Ahmed-Amr-Farouk/-FPGA-CNN-Accelerator/Report/FSM States.png

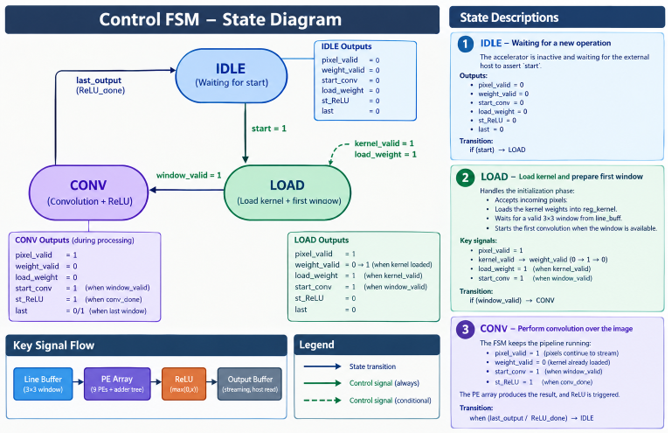
Report/FSM States.png
