Ahmed-Amr-Farouk/-FPGA-CNN-Accelerator/FPGA_Vivado/On-Chip Power Summary (Vivado, .saif Activity Applied).jpg

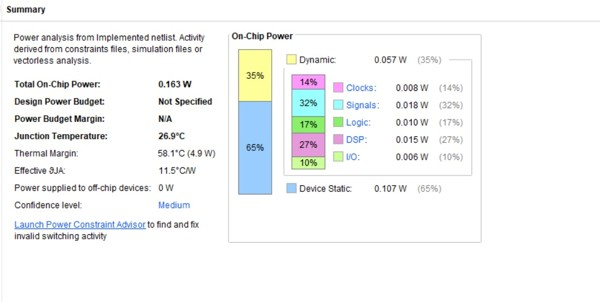
FPGA_Vivado/On-Chip Power Summary (Vivado, .saif Activity Applied).jpg
