Ahmed-Amr-Farouk/-FPGA-CNN-Accelerator/FPGA_Vivado/RTL Schematic Post-Synthesis.jpg

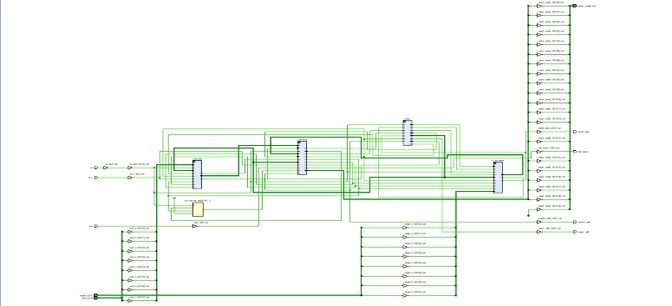
FPGA_Vivado/RTL Schematic Post-Synthesis.jpg
