Ahmed-Amr-Farouk/-FPGA-CNN-Accelerator/FPGA_Vivado/RTL Schematic.jpg

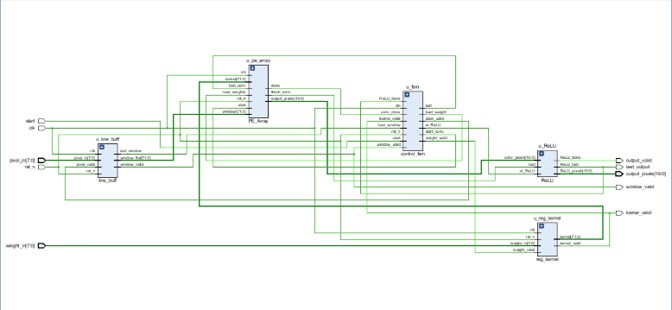
FPGA_Vivado/RTL Schematic.jpg
