Ahmed-Amr-Farouk/-FPGA-CNN-Accelerator/Report/System-Level Block Diagram.png

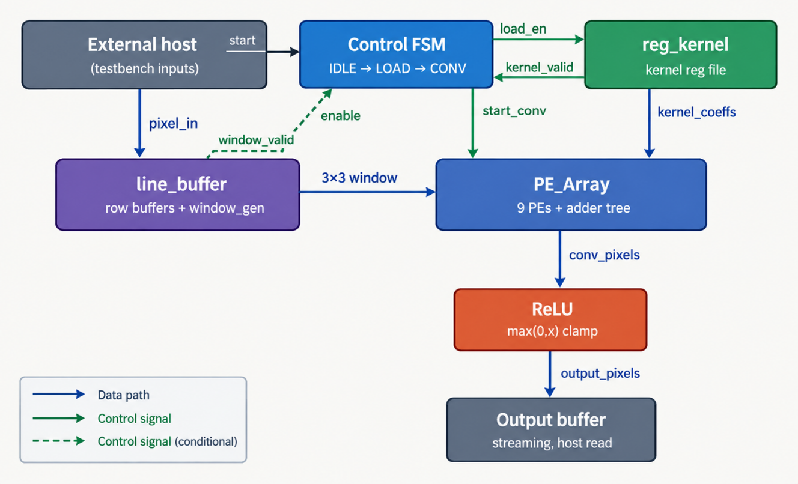
Report/System-Level Block Diagram.png
