Ahmed-Amr-Farouk/-FPGA-CNN-Accelerator/Questa-Simulation RTL & TB/export_Test/test_cases/case_list.txt

showcase_identity
showcase_edge_h
showcase_edge_v
showcase_sharpen
showcase_box_blur
checkerboard_box_blur
ramp_edge_h
max_value_sharpen
random_edge_v
